lucasbustamante/PIXIE/STL/Charm-Cam-Front-v1.stl

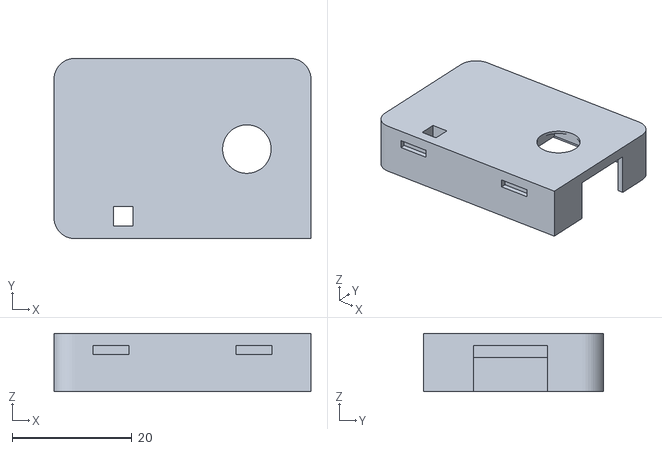
[picture p1: CAD file, 2026-06-02]
STL/Charm-Cam-Front-v1.stl
42.9 x 30.1 x 9.70
