lucasbustamante/PIXIE/STL/Charm-Cam-Parts-Holder-v1.stl

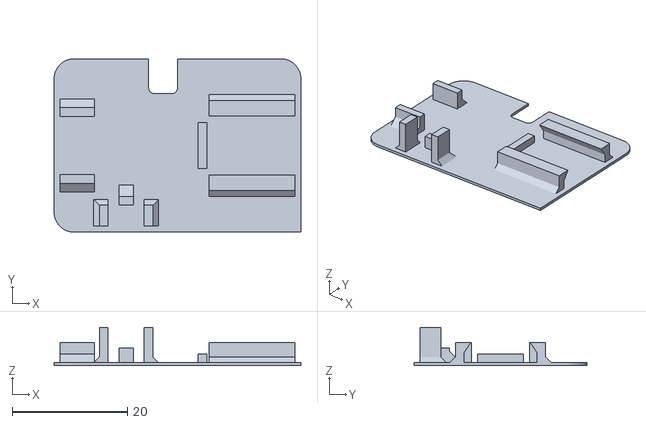
[picture p2: CAD file, 2026-06-02]
STL/Charm-Cam-Parts-Holder-v1.stl
42.9 x 30.1 x 6.60
