lucasbustamante/PIXIE/STL/Charm-Cam-Lens-v1.stl

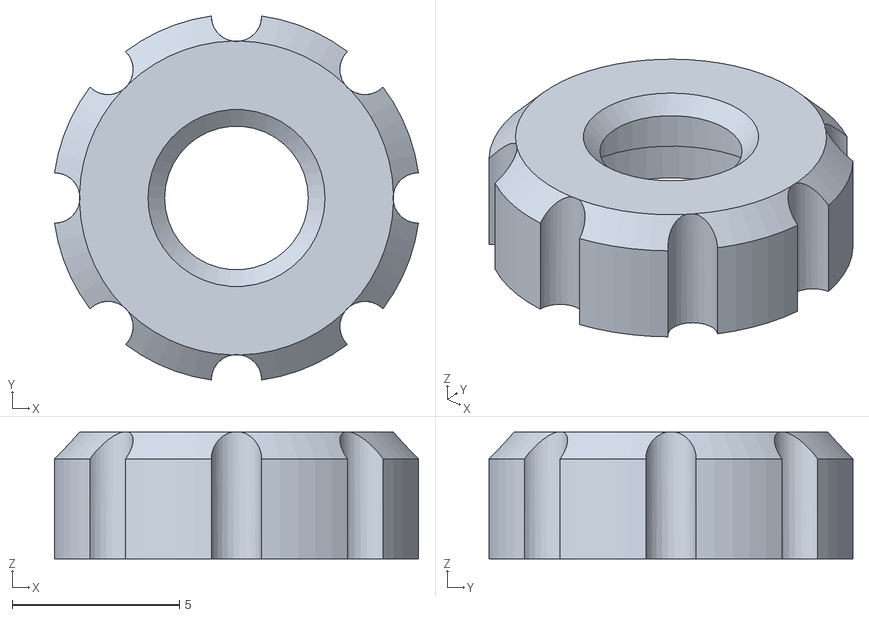
[picture p3: CAD file, 2026-06-02]
STL/Charm-Cam-Lens-v1.stl
10.9 x 10.9 x 3.80
