lucasbustamante/PIXIE/STL/Charm-Cam-Flash-v1.stl

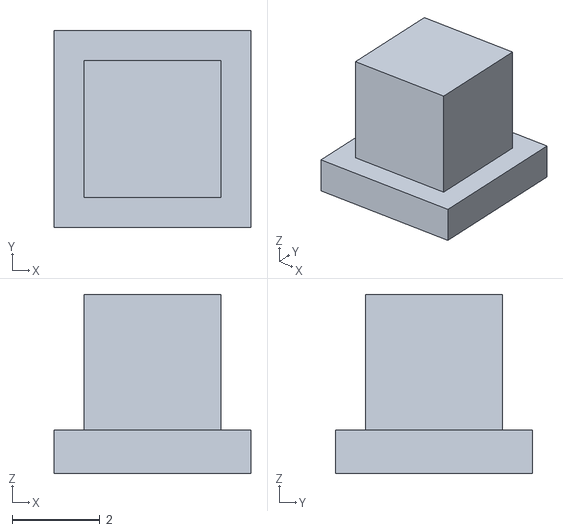
[picture p4: CAD file, 2026-06-02]
STL/Charm-Cam-Flash-v1.stl
4.50 x 4.50 x 4.10
