lucasbustamante/PIXIE/STL/Charm-Cam-Cage-v1.stl

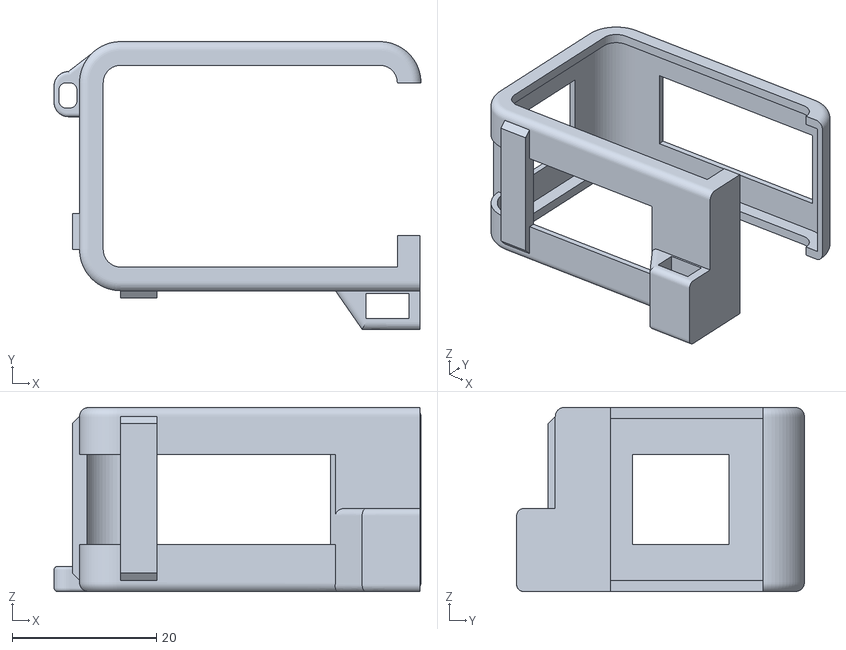
[picture p5: CAD file, 2026-06-02]
STL/Charm-Cam-Cage-v1.stl
50.8 x 39.9 x 25.5
