lucasbustamante/PIXIE/STL/Charm-Cam-ESP-Cover-v1.stl

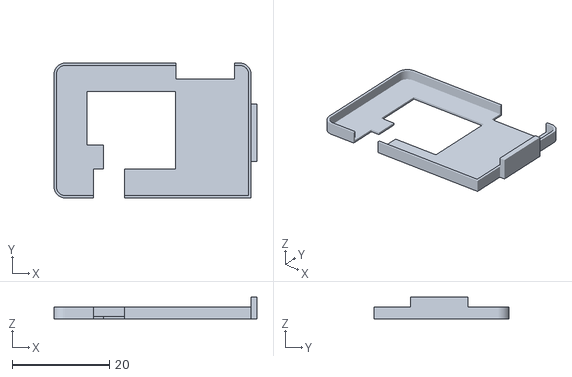
[picture p6: CAD file, 2026-06-02]
STL/Charm-Cam-ESP-Cover-v1.stl
41.7 x 27.7 x 4.50
