lucasbustamante/PIXIE/STL/Charm-Cam-Back-v1.stl

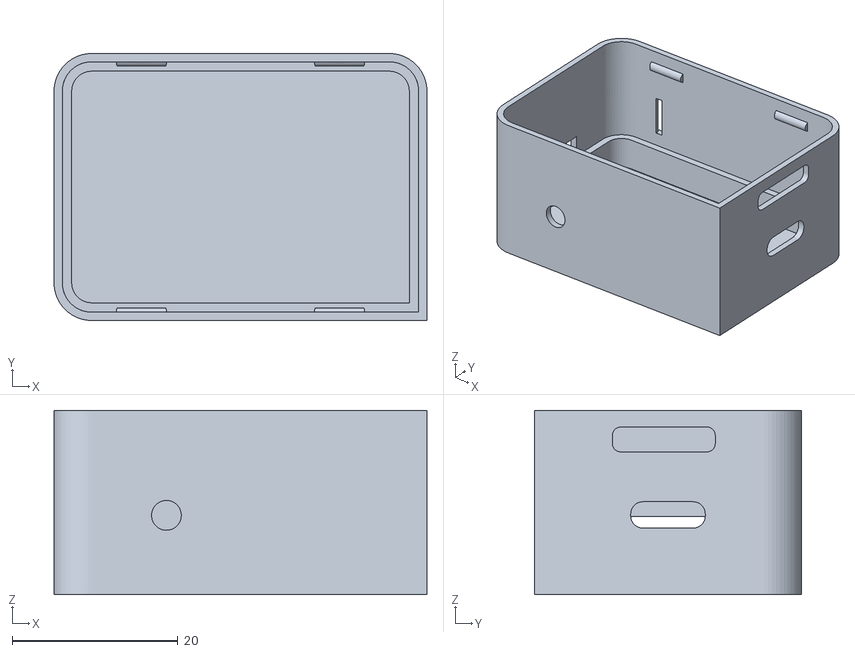
[picture p7: CAD file, 2026-06-02]
STL/Charm-Cam-Back-v1.stl
45.0 x 32.2 x 22.2
